Valentin-Golyonko/RGBStripControl_Arduino/RGBStripControl_Arduino/PCB.png

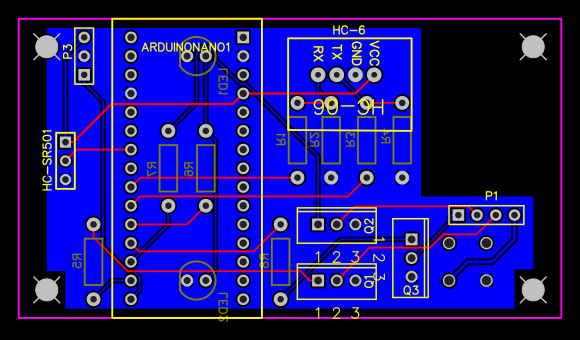
RGBStripControl_Arduino/PCB.png
