Valentin-Golyonko/RGBStripControl_Arduino/RGBStripControl_Arduino/working board.png

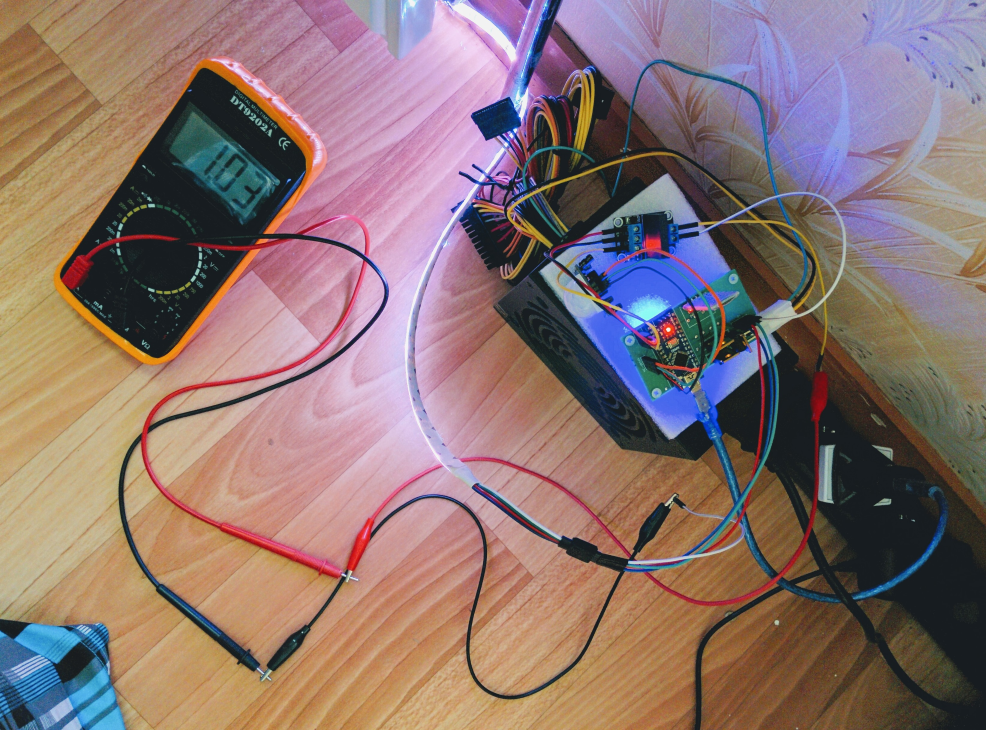
RGBStripControl_Arduino/working board.png
