Valentin-Golyonko/RGBStripControl_Arduino/RGBStripControl_Arduino/RGBStripControl_Arduino.pdf

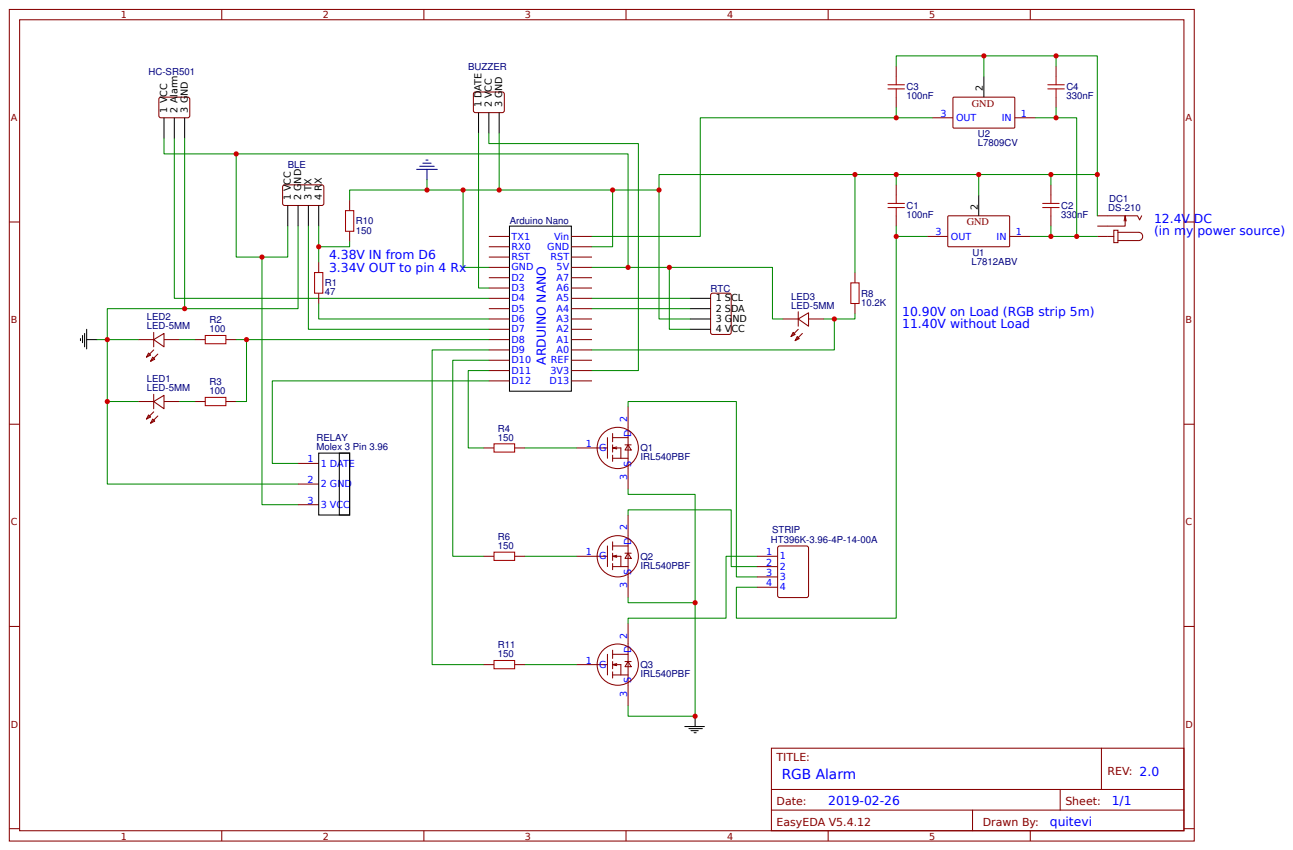
[picture p6: page 1]

HC-SR501 1 VCC 2 Alarm 3 GND

BUZZER 1 DATE 2 VCC 3 GND

BLE 1 VCC 2 GND 3 TX

(in my power source)
