Valentin-Golyonko/RGBStripControl_Arduino/(commit log)

2018-06-02 schematic and PCB added
2018-12-25 added: rtc (alarm), buzzer, photoresistor.
    [RGBStripControl_Arduino.ino, functions.h]
2019-01-27 alarm fix, settings menu added
    [RGBStripControl_Arduino.ino, functions.h, music.h]
